kymok/4u_spacebar_buildlog/README.md

# 4u-Sized Space Bar Build Log

これは [キーボード #1 Advent Calendar 2019](https://adventar.org/calendars/4117) 2日目の記事です．

- [Build log (in Japanese)](Making_a_4u_spacebar_ja.md)
- See [model](./model/) directory for 3D model (3dm/STL).
