kymok/4u_spacebar_buildlog/img/trial_1.jpg

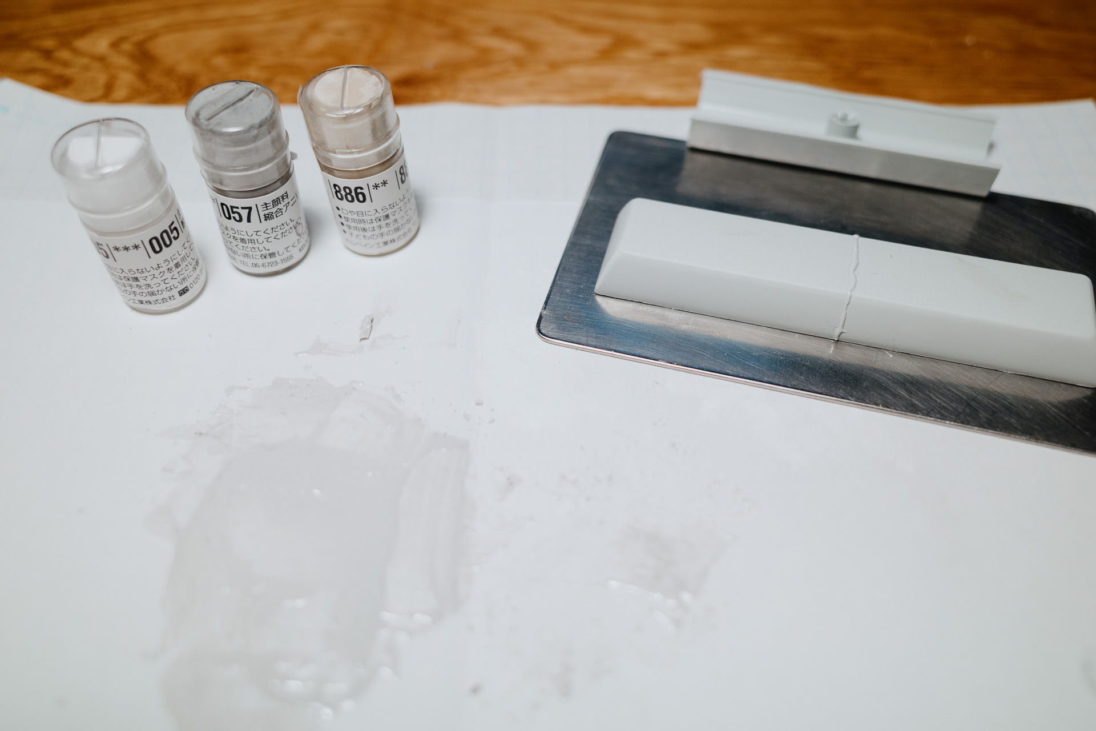
img/trial_1.jpg
