kymok/4u_spacebar_buildlog/model/spacebar_backplate.stl

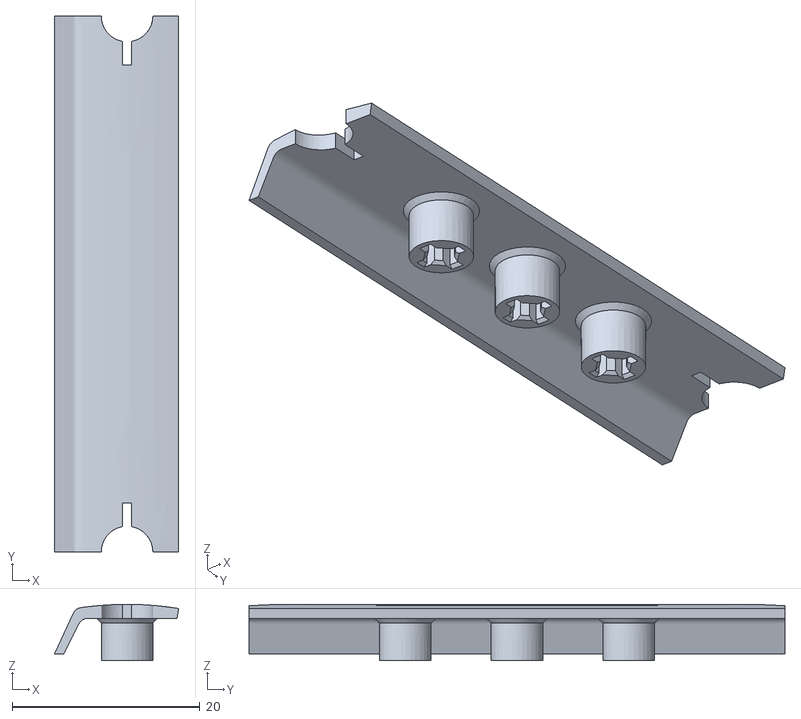
[picture p2: CAD file, 2019-12-01]
model/spacebar_backplate.stl
13.2 x 57.2 x 6.00
