kymok/4u_spacebar_buildlog/(list of files, cad)

Other CAD files:
model/spacebar_backplate.3dm
